JMan7777/Mitsubishi-Aircon-SmartThings/(commit log)

2020-04-15 Compatibility update
    Compatibility update to support the latest https://github.com/SwiCago/HeatPump version (incl. pull request #158 )
2020-04-19 Added prototype information.
2020-04-22 Fixed hSwing modes
    - Replaced wrong hSwing mode "AUTO" by "<>".
    - Reset Refresh button if settings are changed
2020-05-07 Fixed tempUp and tempDown if temperature unit is C
2020-07-17 Fixed WiFi auto-reconnect
    Sometimes if the WiFi connection is lost, because of e.g. a router reboot or WiFi channel change the ESP could not reconnect and needed to be rebooted.
    Now the ESP tries to reconnect properly and if it still fails it will reboot automatically.
    [Mitsubishi_Aircon_ESP32.ino]
